daniel-santos-7/dpga-ieee-sscs-contest/README.md

# DIGITALLY PROGRAMMABLE GAIN AMPLIFIER

## 1. LIST OF THE INVOLVED TEAM MEMBERS

- Francisco de Assis Brito Filho (Faculty member)
- Hugo Dias Giló (Undergraduate student)
- Daniel Da Silva Santos (Undergraduate student)

## 2. A SHORT DESCRIPTION OF THE CIRCUIT

<p align="justify">The proposed circuit is a Digitally Programmable Gain Amplifier (DVGA) which will work to amplify voltage signal with programmable gain options, ranging from 1 V / V to 256 V / V. The main core is an OTA Miller with output buffer configured as an inverter amplifier. The circuit feedback resistances is controlled by 8 CMOS switches (Transmission Gates) that are configured according to binary word stored in the shift register which is connected to a Serial Peripheral Interface (SPI) that provides a connection for external control.</p>

## 3. PERFORMANCE SUMMARY TABLE

| Parameter |  Specification | Unit |
| --- | --- | --- |
| Vdd | 1.8 | V |
| Output Swing | (1.8 -0.64) | V |
| Open-loop Gain | 42.3 | dB |
| Programmable gain range | 4.6-250 | V/V |
| GBW | 2.8 | MHz |
| Phase margin | 47 | ° |
| Slew Rate | 0.7 | V/us |
| CMRR | 88 | dB |
| Area | 0.03 | mm² |

**Table 1** – DPGA performance.

## 4. A BLOCK DIAGRAM

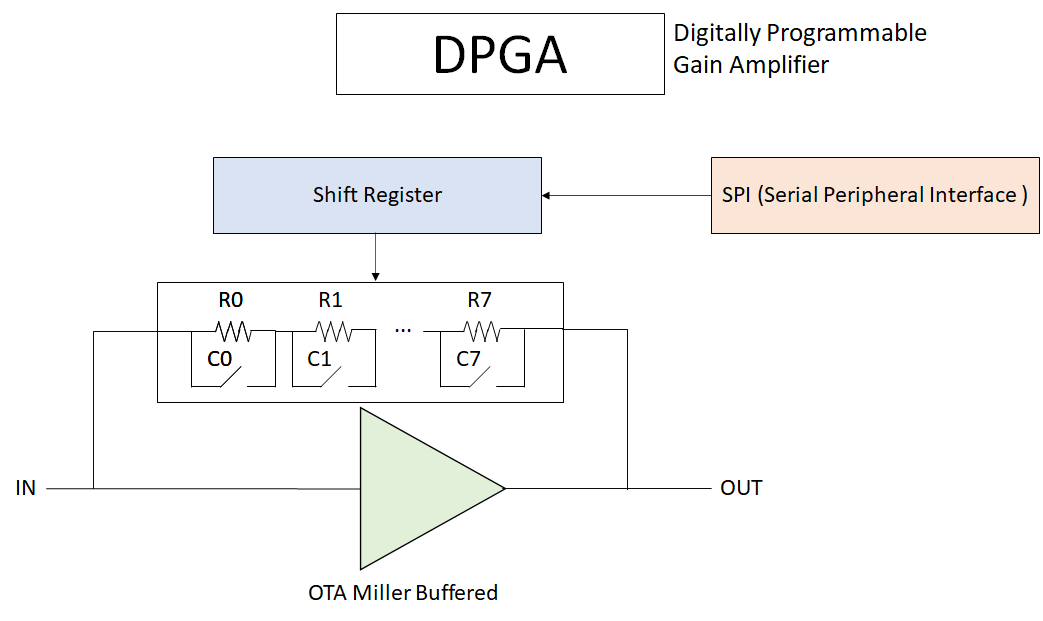
[picture p1: .github/dpga-block-diagram.png]


**Figure 1** – DPGA Block Diagram.

<p>The circuit is composed by an operational amplifier with adjusted gain programmable using CMOS switches. The programmable interface is a serial input as an SPI in order to provide access to external devices to control the gain.</p>

## 5. SCHEMATICS OF THE CRITICAL CIRCUIT CORE

Below are the schematics of the critical circuit core, an Operational Amplifier using the OTA Miller with output buffer.

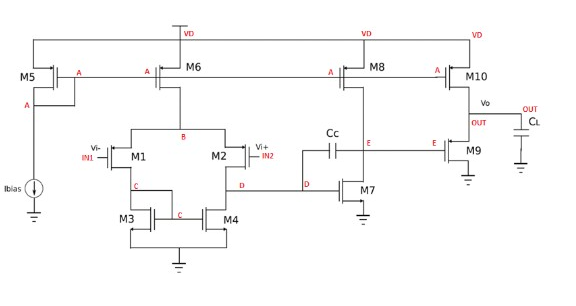
[picture p2: .github/ota-miller-with-output-buffer.png]


**Figure 2** - OpAmp with digitally programmable schematic.

<p align="justify">The negative feedback loop of the Operational Amplifier has resistances controlled by CMOS switches in order to program the overall gain, as in figure 3.</p>

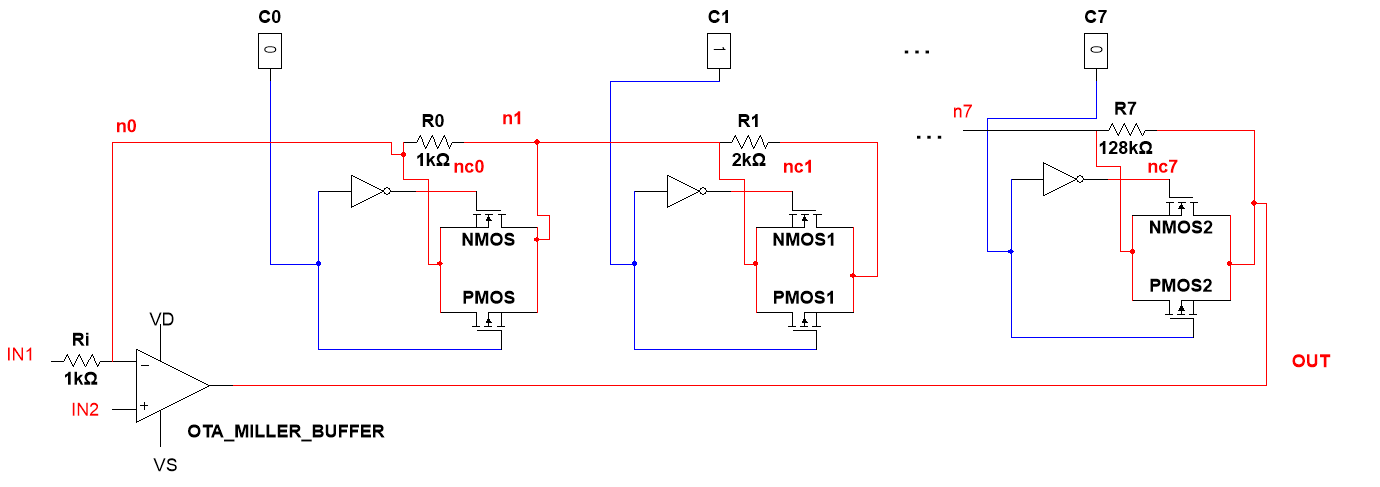
[picture p3: .github/opamp-with-digitally-programmable-schematic.png]


**Figure 3** - OpAmp with digitally programmable schematic.

## 6. CREATED SCHEMATICS
Below are the schematics created in the XSCHEM software.

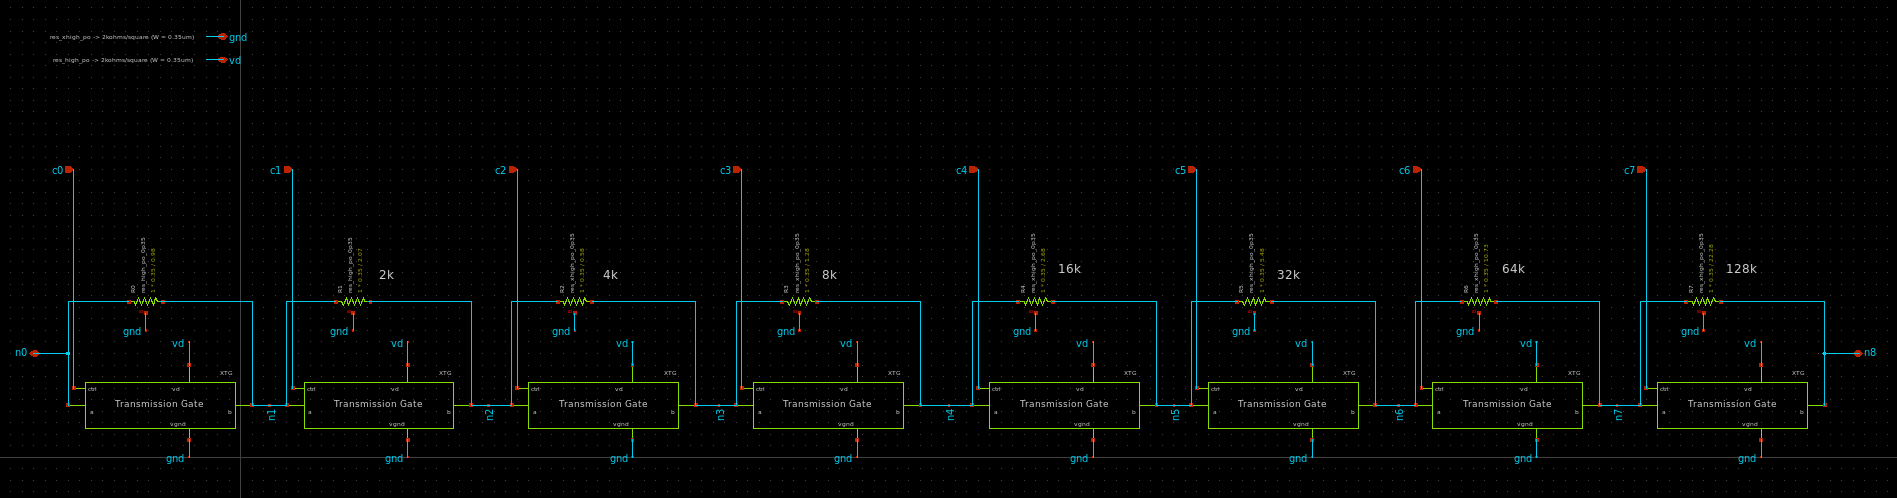
[picture p4: .github/schematic/digpot.png]


**Figure 4** - Digital potentiometer.

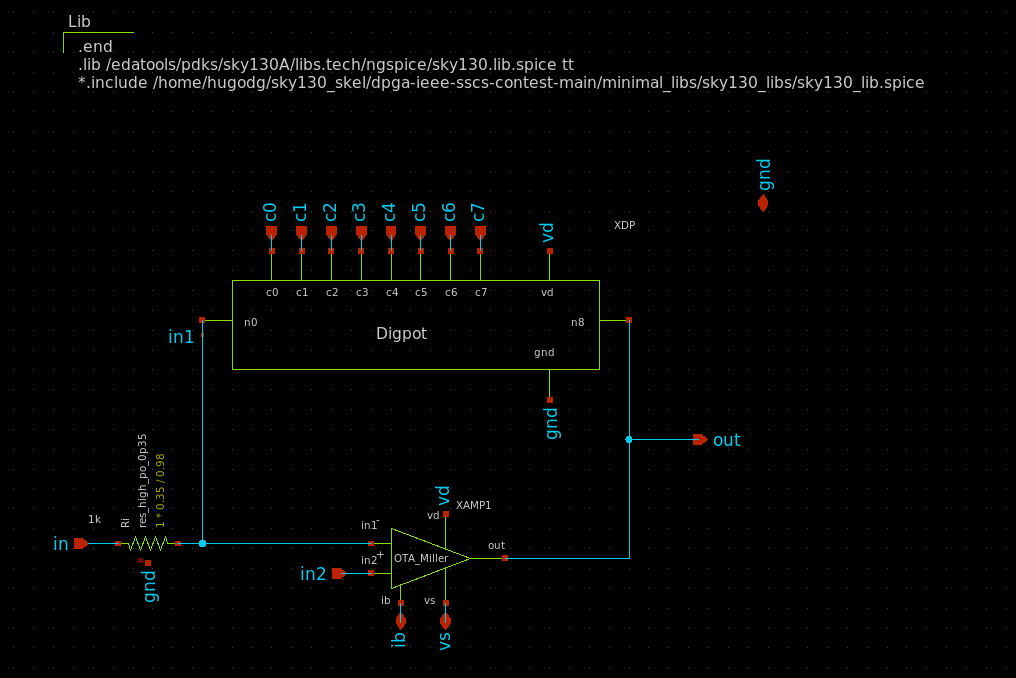
[picture p5: .github/schematic/dpga.png]


**Figure 5** - Digital potentiometer and OTA.

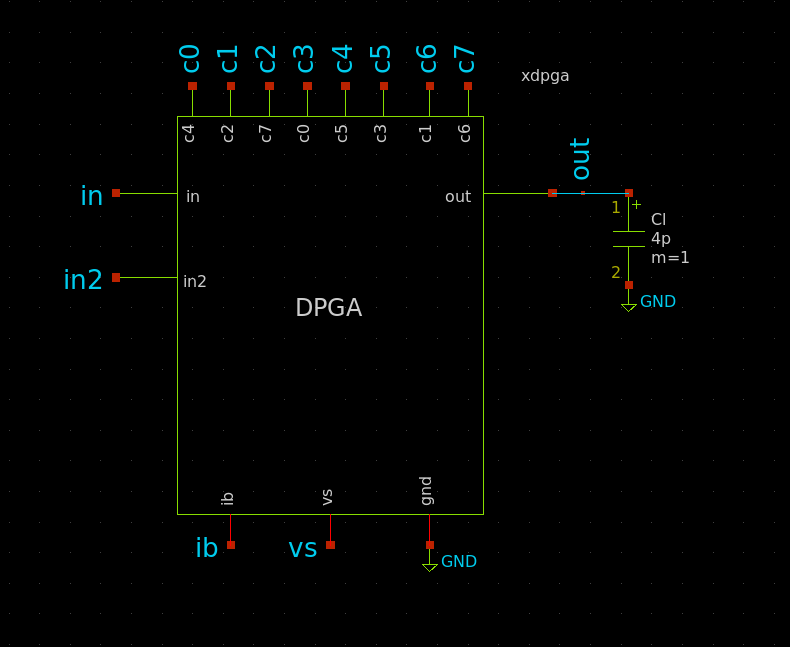
[picture p6: .github/schematic/dpga_with_cload.png]


**Figure 6** - DPGA top entity with load.

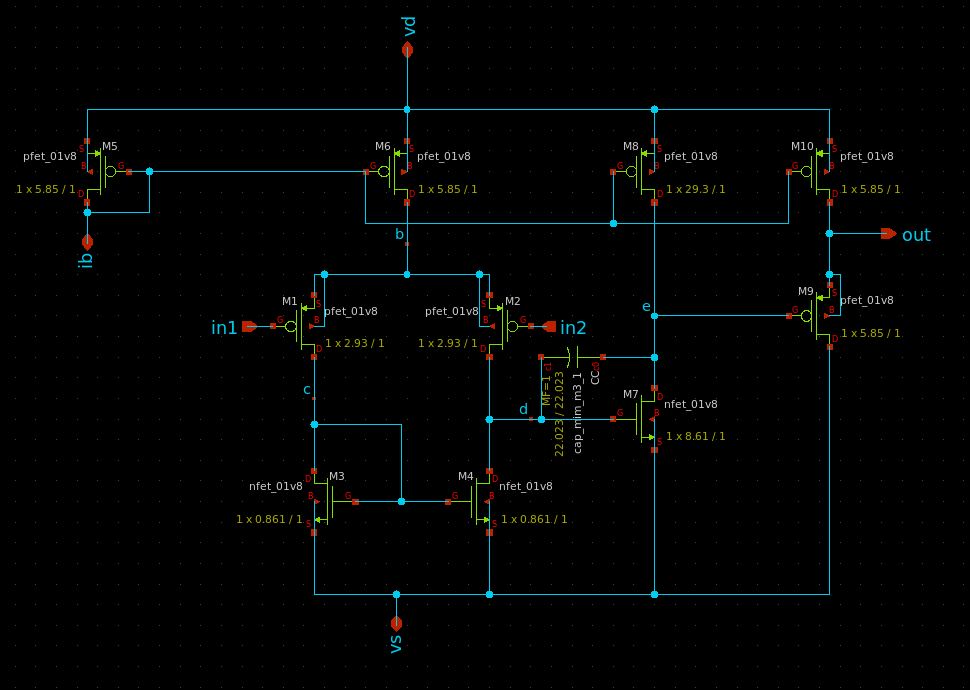
[picture p7: .github/schematic/ota.png]


**Figure 7** - OTA Miller schematic.

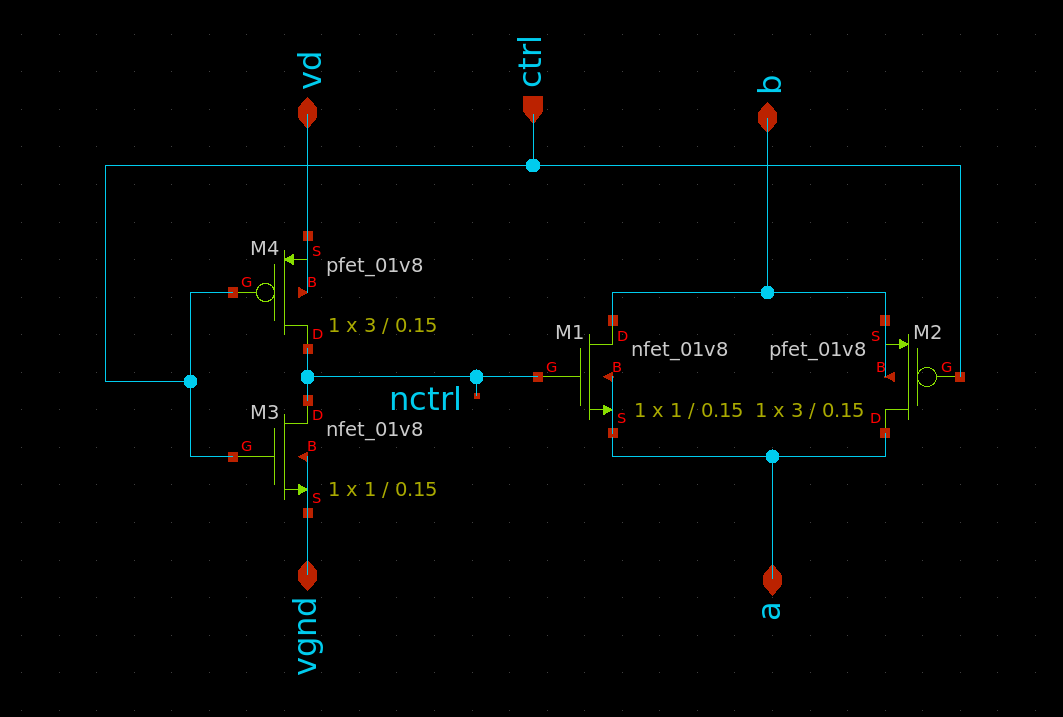
[picture p8: .github/schematic/tg.png]


**Figure 8** - Transmission gate with control.

## 7. Layouts

The analog and digital circuit layouts created will be presented below. 

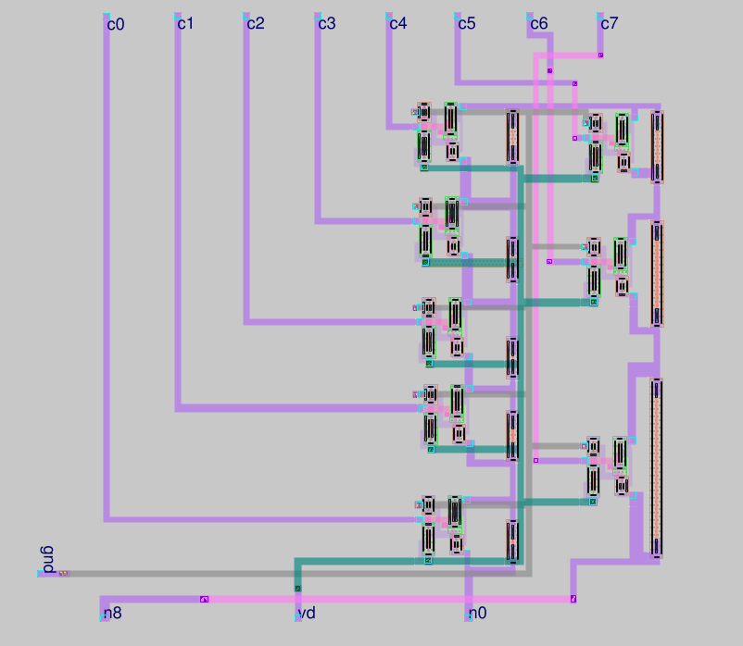
[picture p9: .github/layout/digpot.png]


**Figure 9** - Digital potentiometer layout.

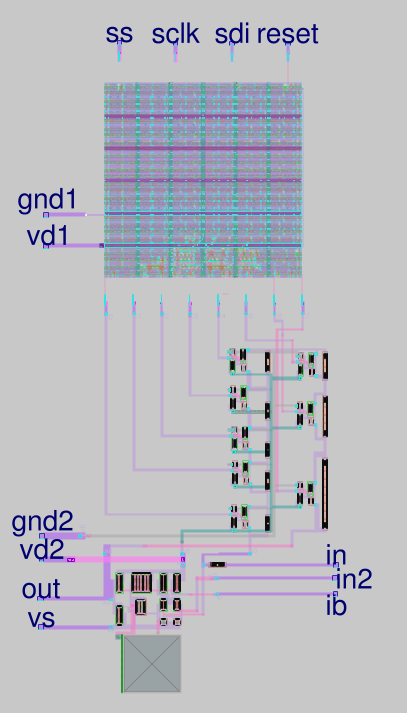
[picture p10: .github/layout/dpga_spi.png]


**Figure 10** - DPGA layout.

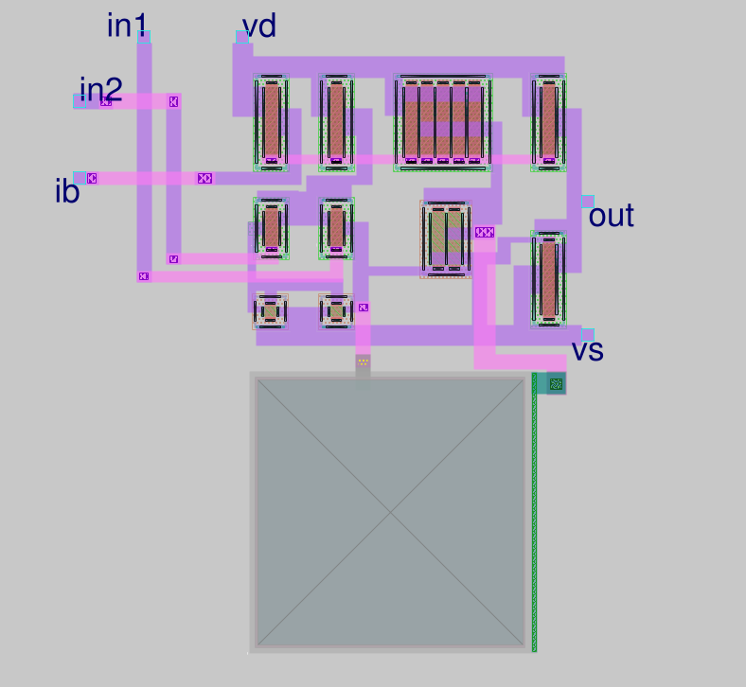
[picture p11: .github/layout/ota.png]


**Figure 11** - OTA Miller layout.

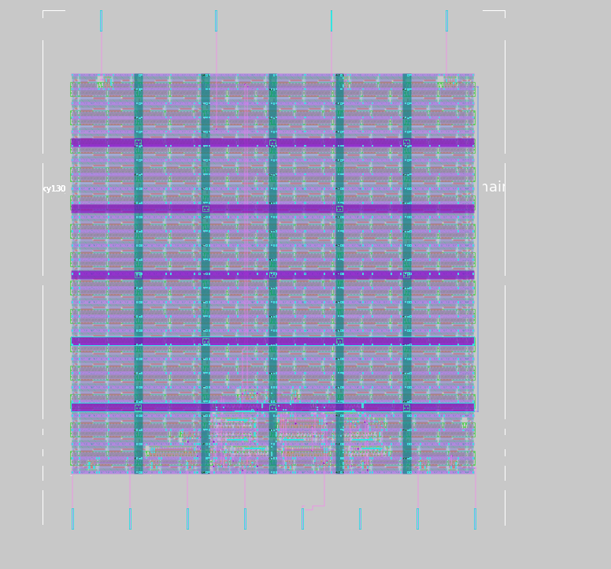
[picture p12: .github/layout/spi.png]


**Figure 12** - SPI module layout.

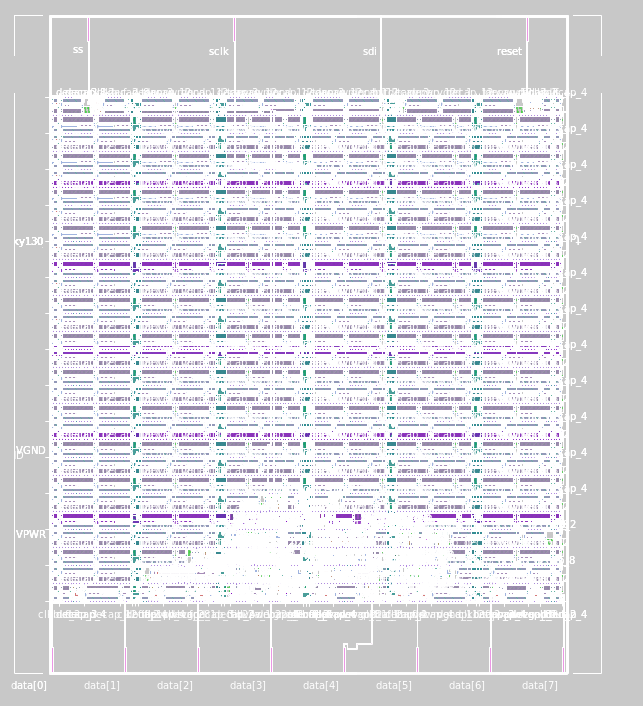
[picture p13: .github/layout/spi_ports.png]


**Figure 13** - SPI module layout with ports highlights.

## 8. Simulations
The results of the simulations carried out will be presented below.

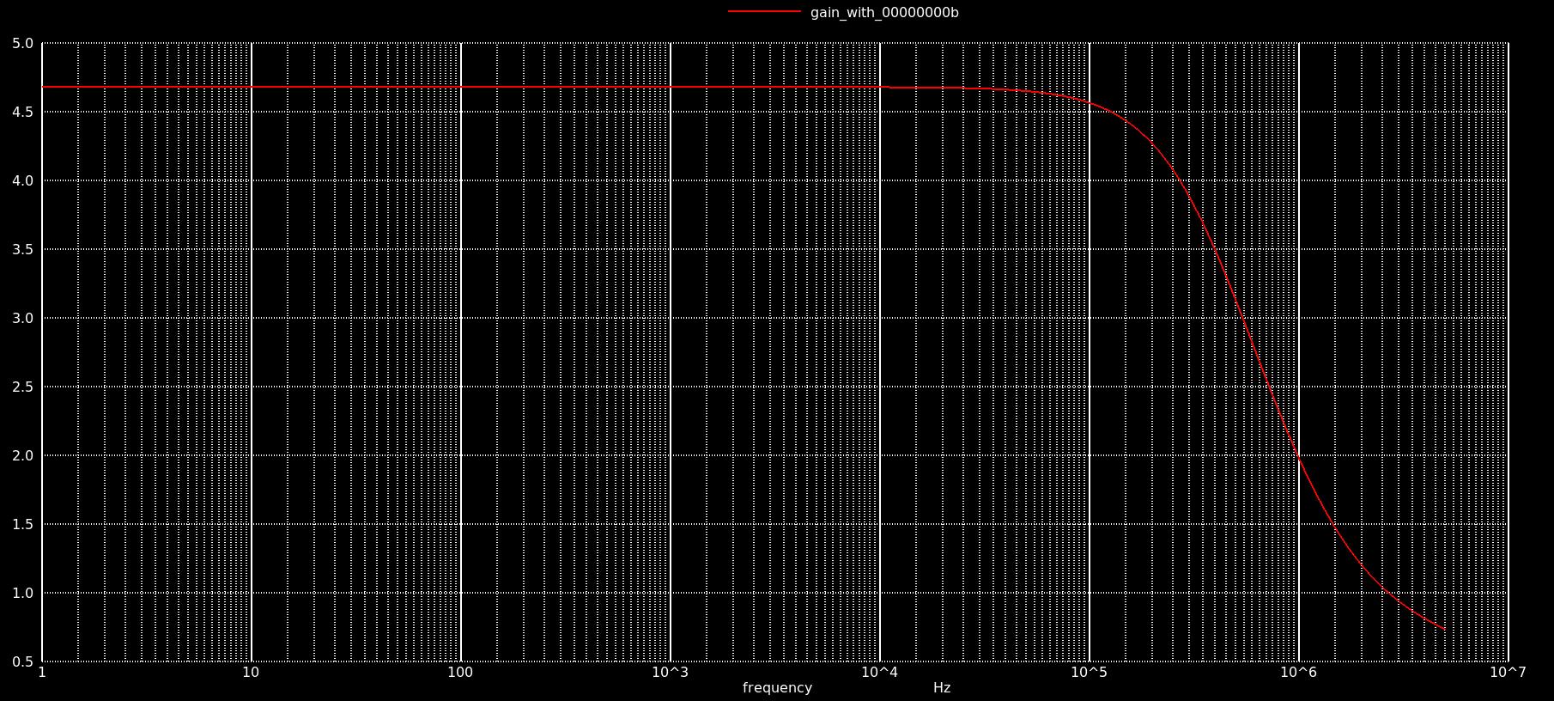
[picture p14: .github/simulations/digpot_tb-00000000b.png]


**Figure 14** - DPGA minimum gain.

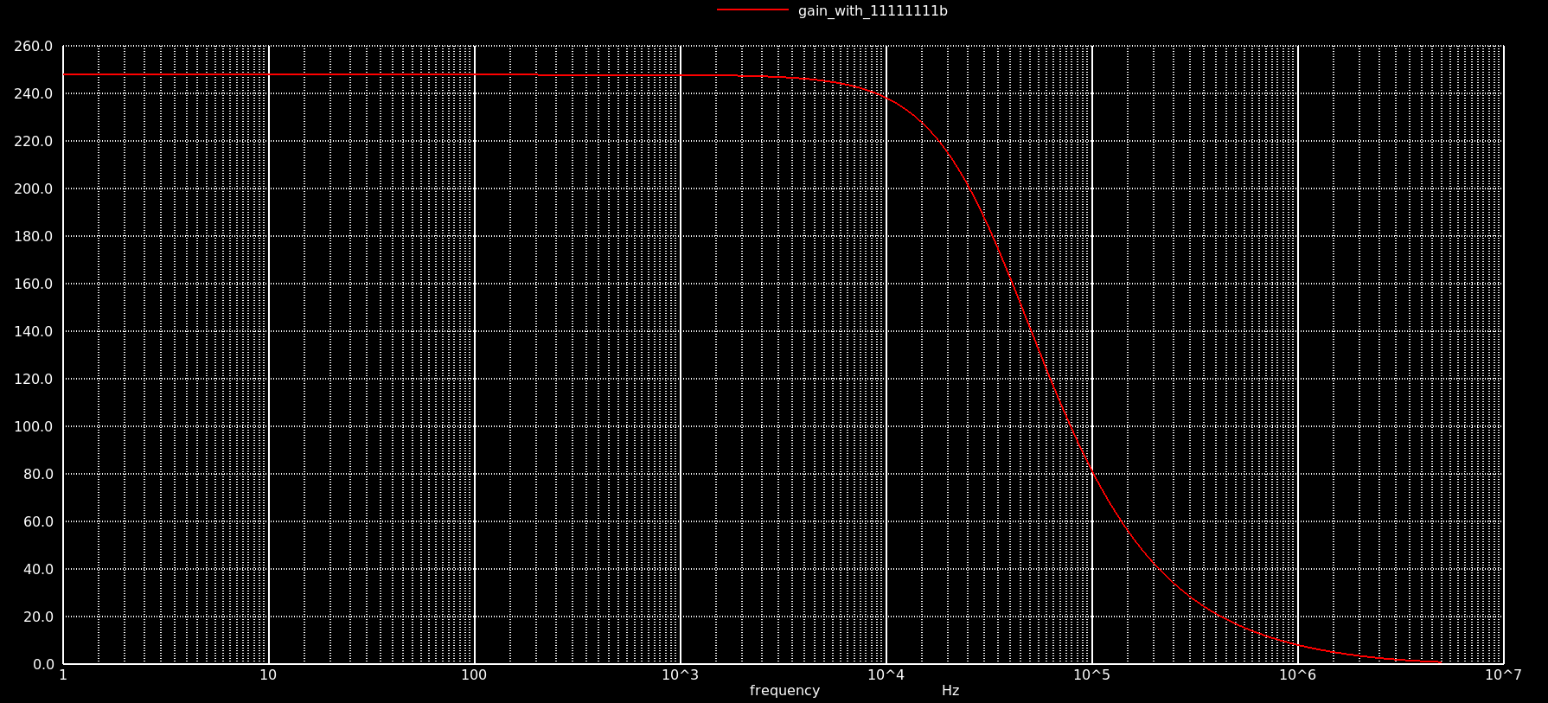
[picture p15: .github/simulations/dpga_tb-11111111b.png]


**Figure 15** - DPGA maximum gain.

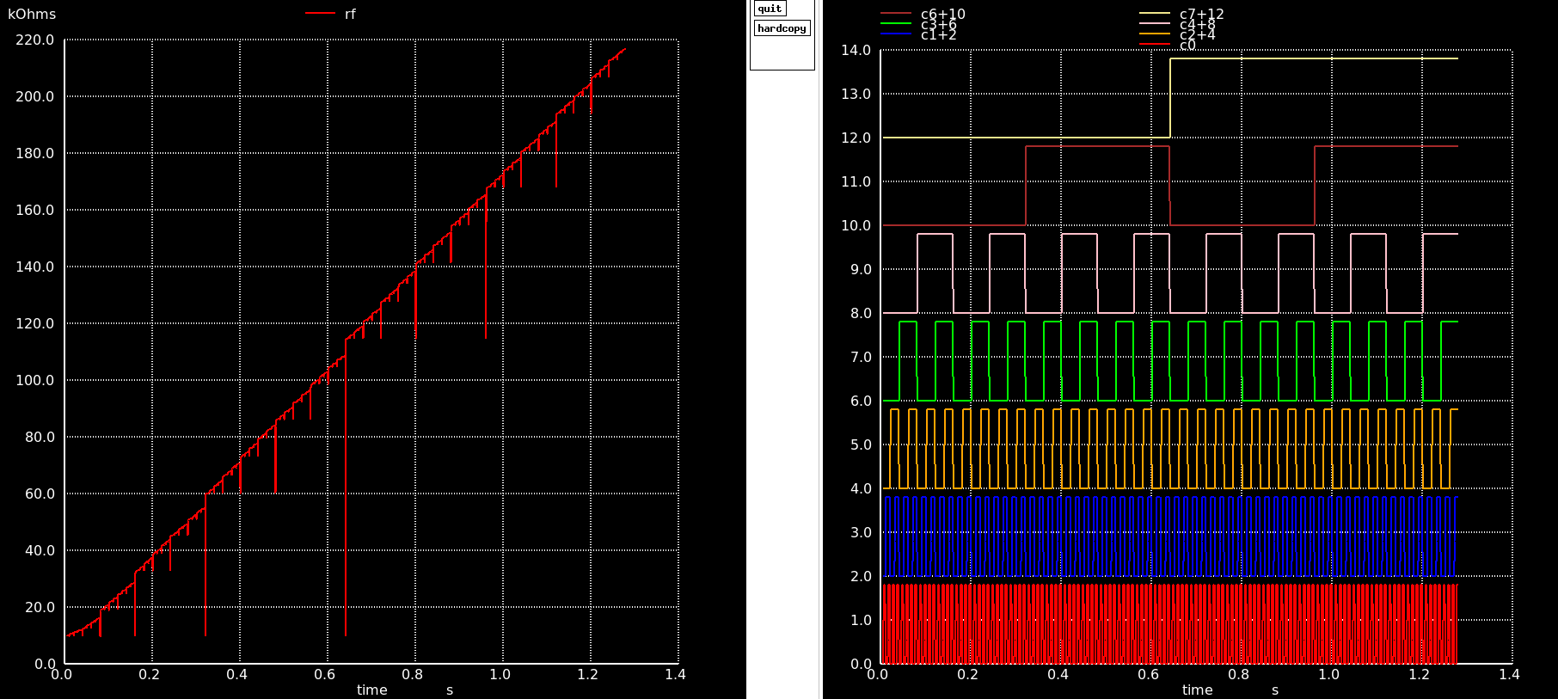
[picture p16: .github/simulations/digpot_tb.png]


**Figure 16** - Digital potentiometer simulation.

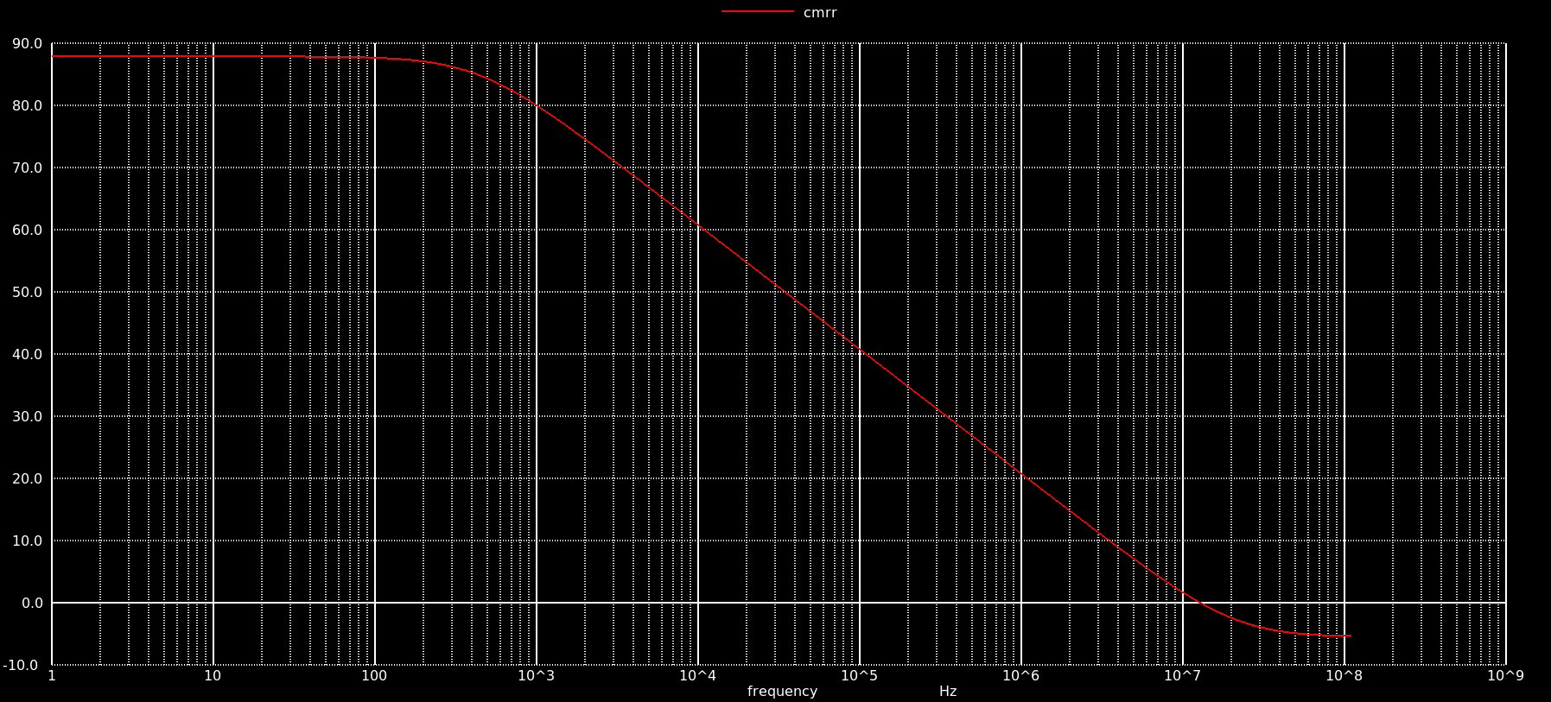
[picture p17: .github/simulations/ota_CMRR.png]


**Figure 17** - OTA CMRR simultation.

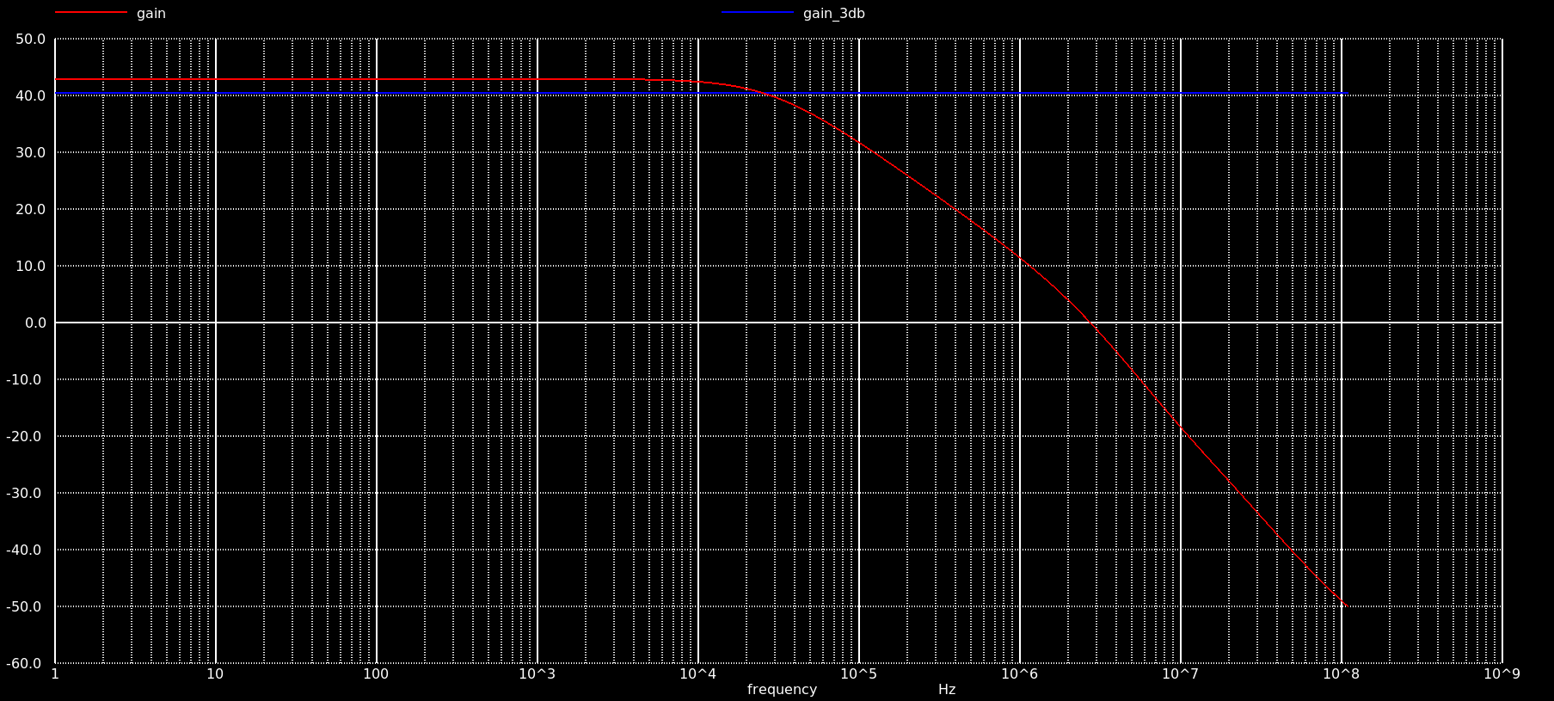
[picture p18: .github/simulations/ota_ac-gain.png]


**Figure 18** - OTA gain.

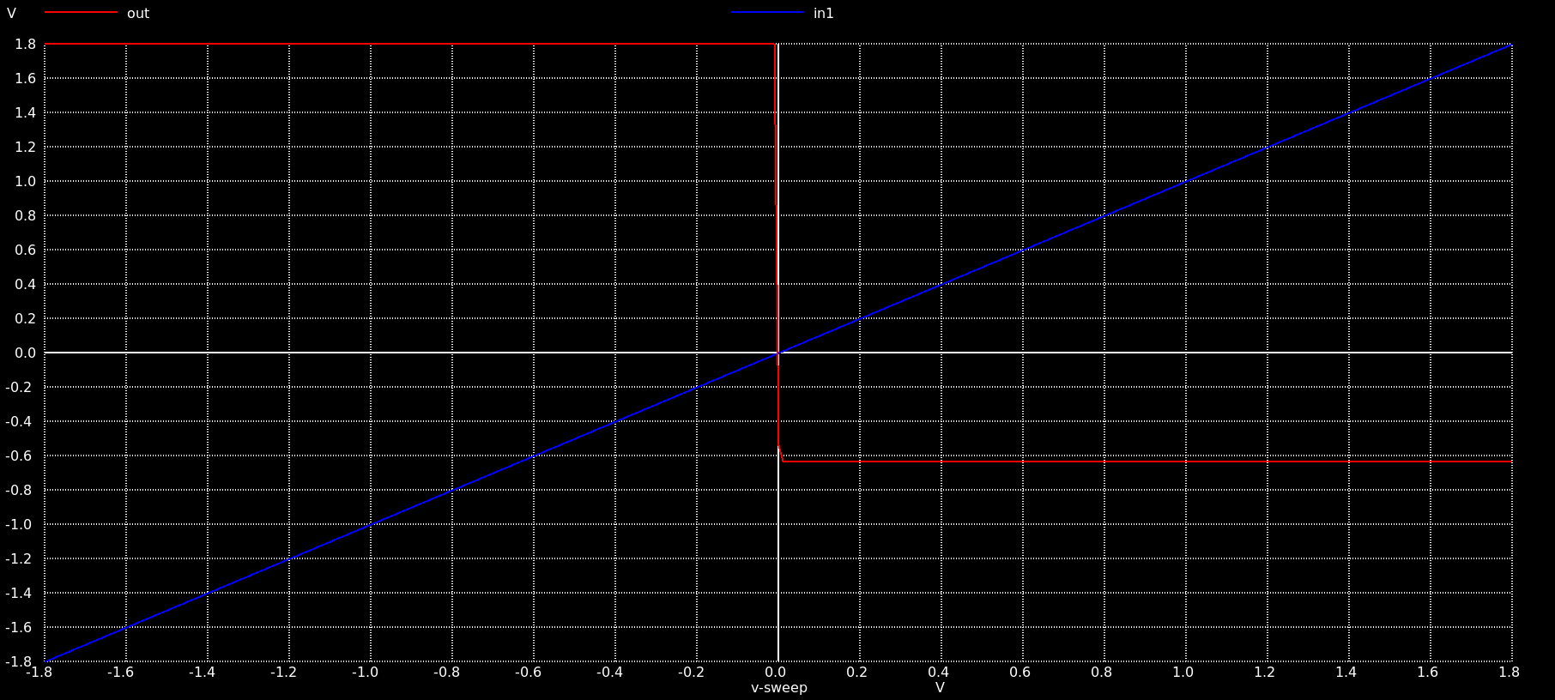
[picture p19: .github/simulations/ota_dc.png]


**Figure 19** - OTA DC simulation.

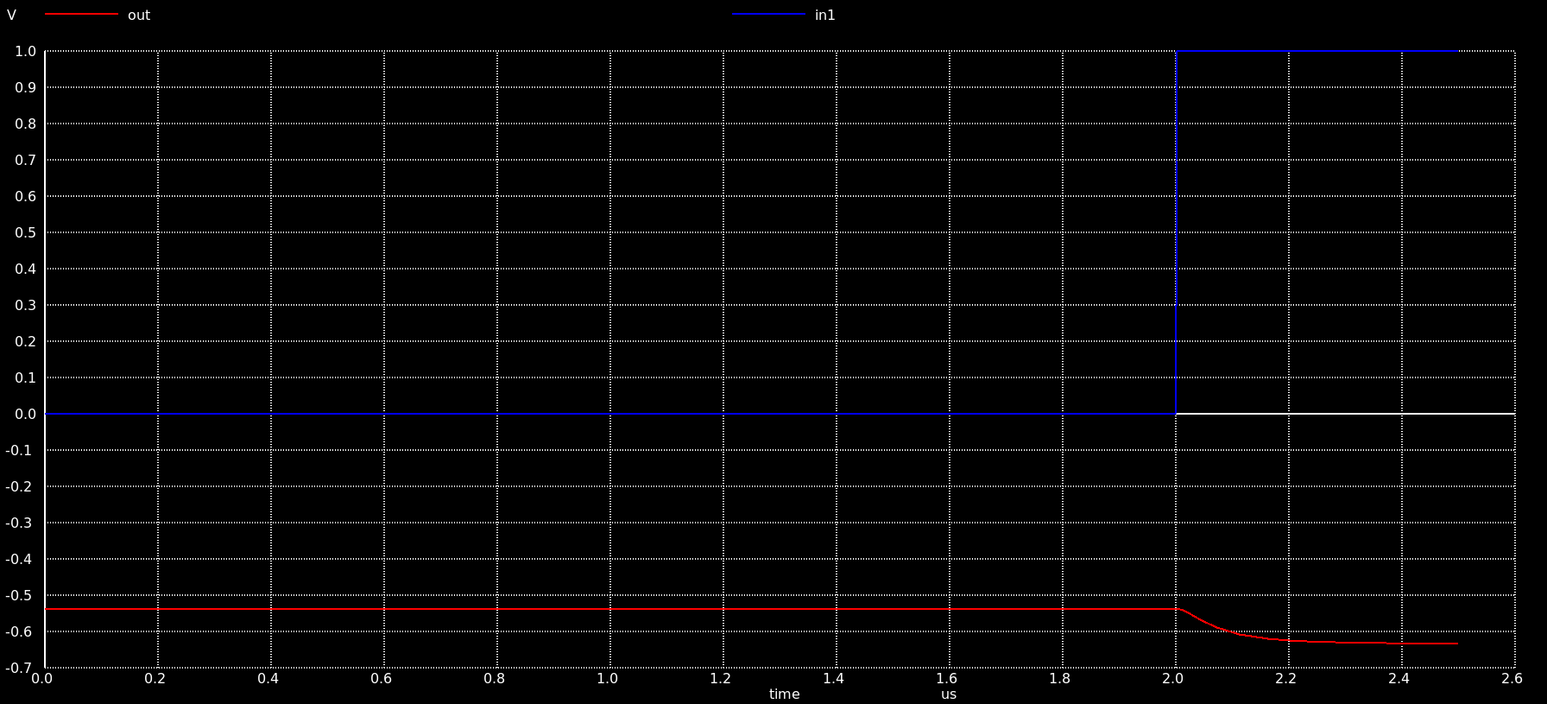
[picture p20: .github/simulations/ota_large-signal.png]


**Figure 20** - OTA large signal simulation.

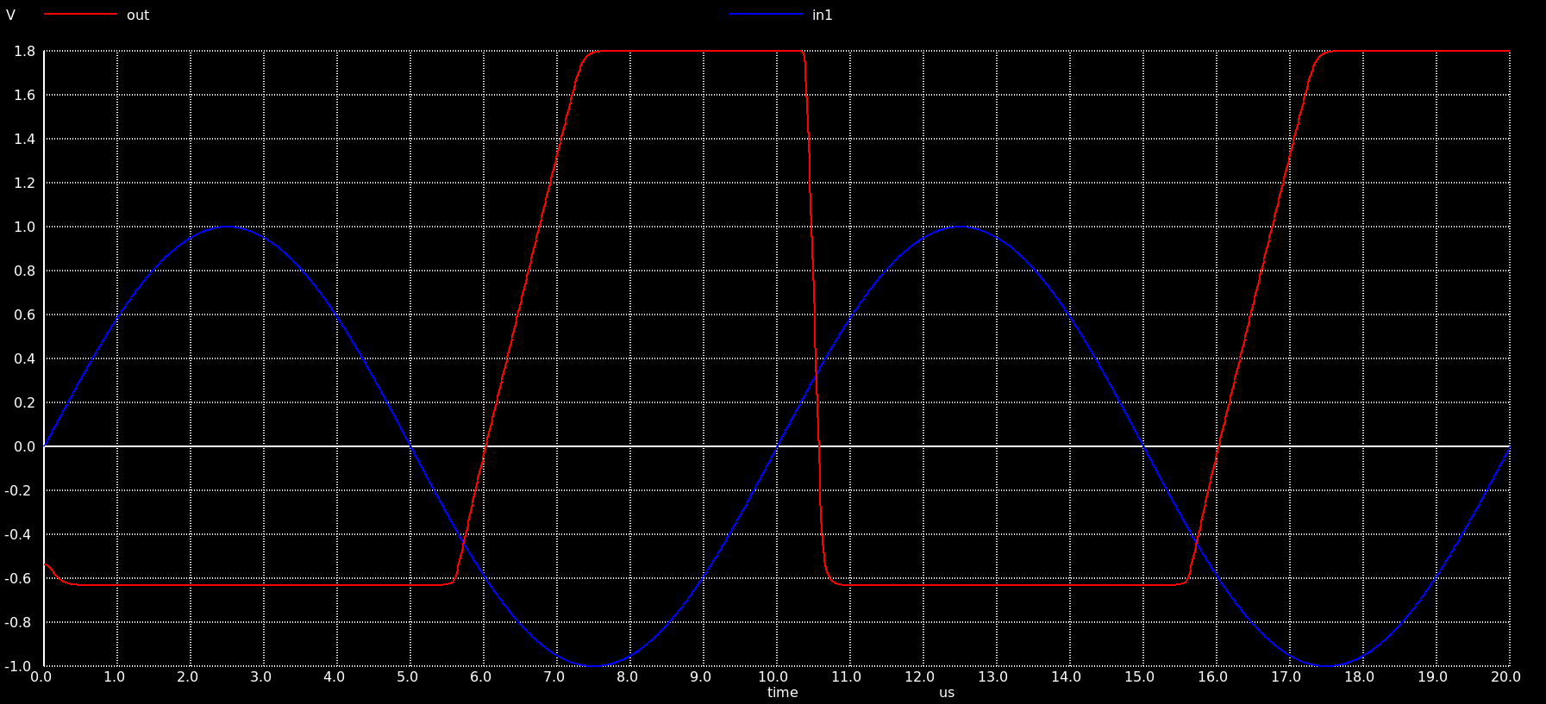
[picture p21: .github/simulations/ota_tran.png]


**Figure 21** - OTA transient simulation.

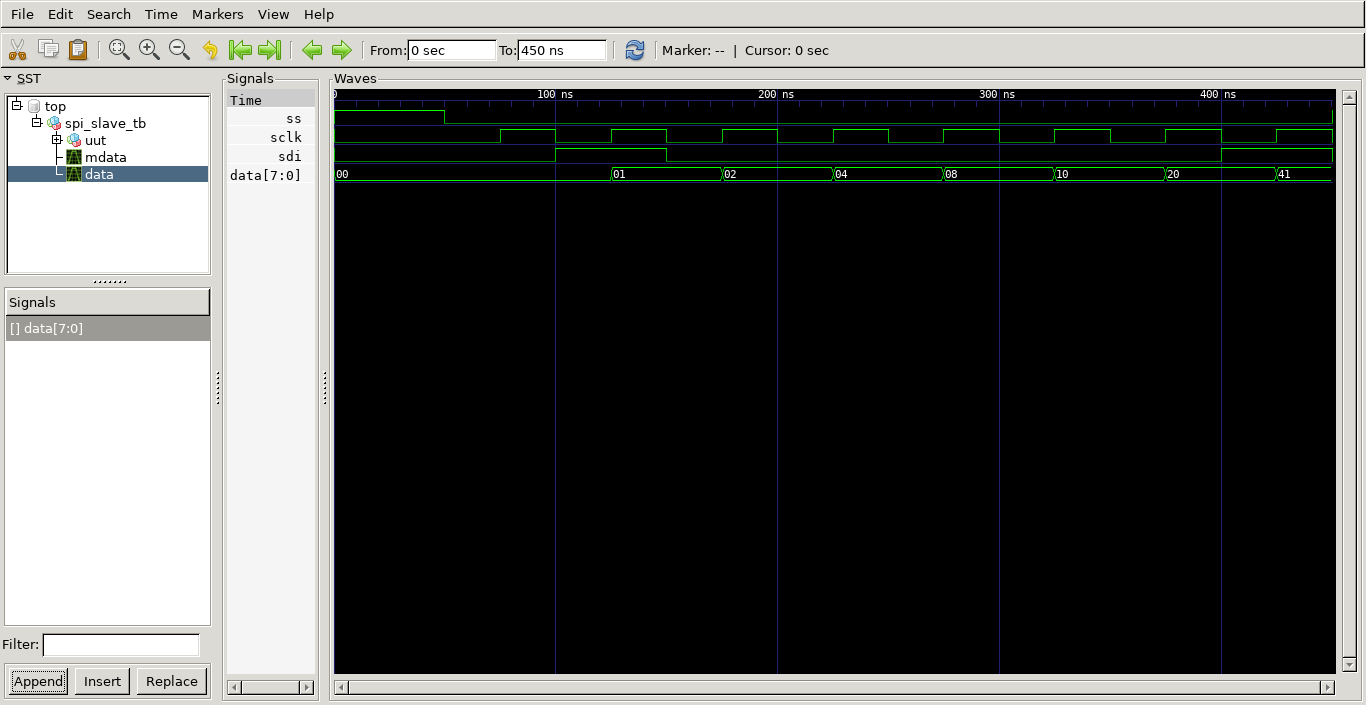
[picture p22: .github/simulations/spi_slave.png]


**Figure 22** - SPI simulation.

## 8. PORTS

| Port | type |
| --- | --- |
| ss | digital input |
| sclk | digital input |
| sdi | digital input |
| reset' | digital input |
| in | analog input |
| in2 | analog input |
| Ib | analog input |
| out | analog output |
| vd1 | power |
| gnd1 | power |
| vd2 | power |
| vs | power |
| gnd2 | power |

## 9. APPLICABLE REFERENCES

Main references for OpAmp Design are:

- P. E. Allen, D. R. Holberg. CMOS Analog Circuit Design. 2nd Ed., Oxford, New York, 2002.
- B. Razavi. Design of Analog CMOS Integrated Circuits. McGraw -Hill, New York, 2001.
- P. Jespers, B. Murmann. Systematic Design of Analog CMOS Circuits: Using Pre-Computed Lookup. Cambridge Press. 2017.
