daniel-santos-7/dpga-ieee-sscs-contest/.github/simulations/ota_ac-phase.png

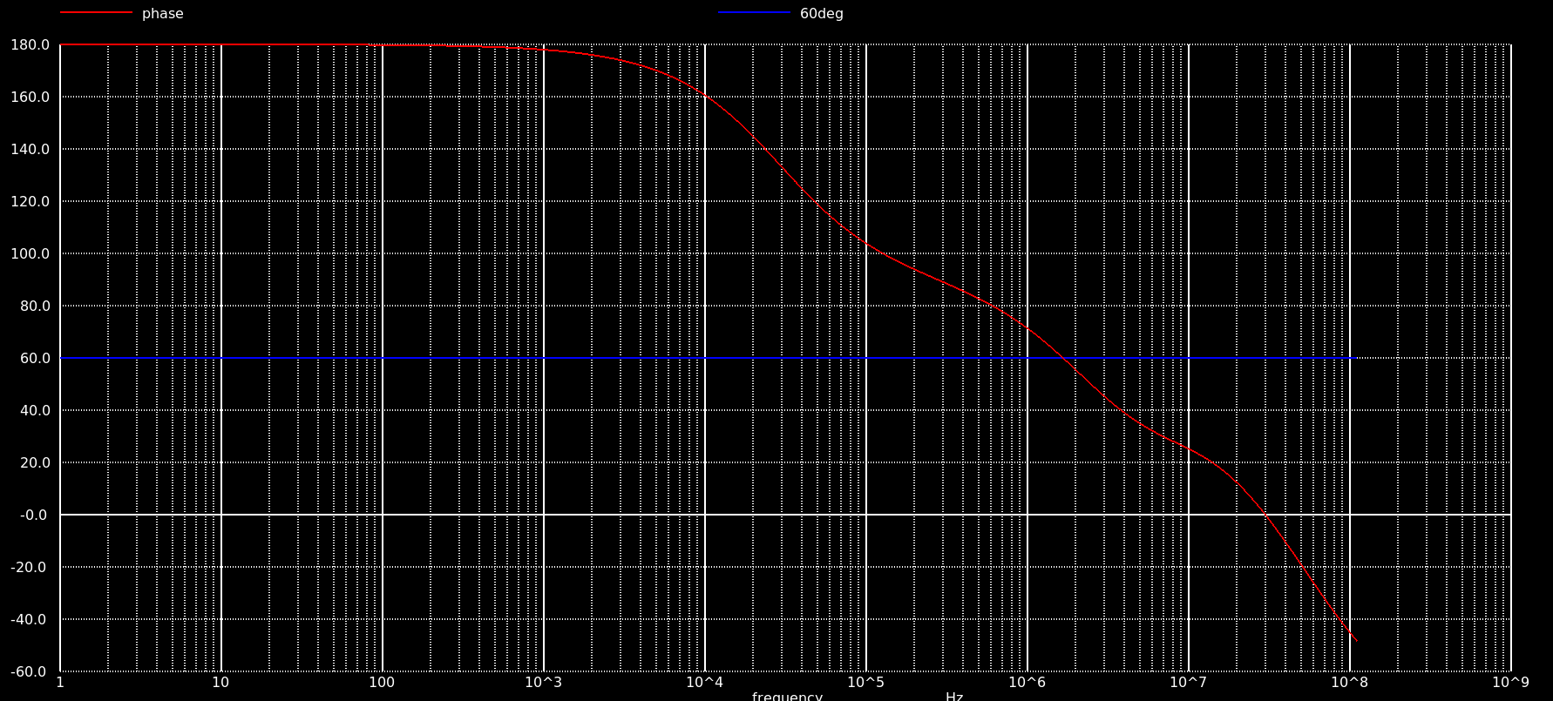
.github/simulations/ota_ac-phase.png
