daniel-santos-7/dpga-ieee-sscs-contest/.github/simulations/tg_tb.png

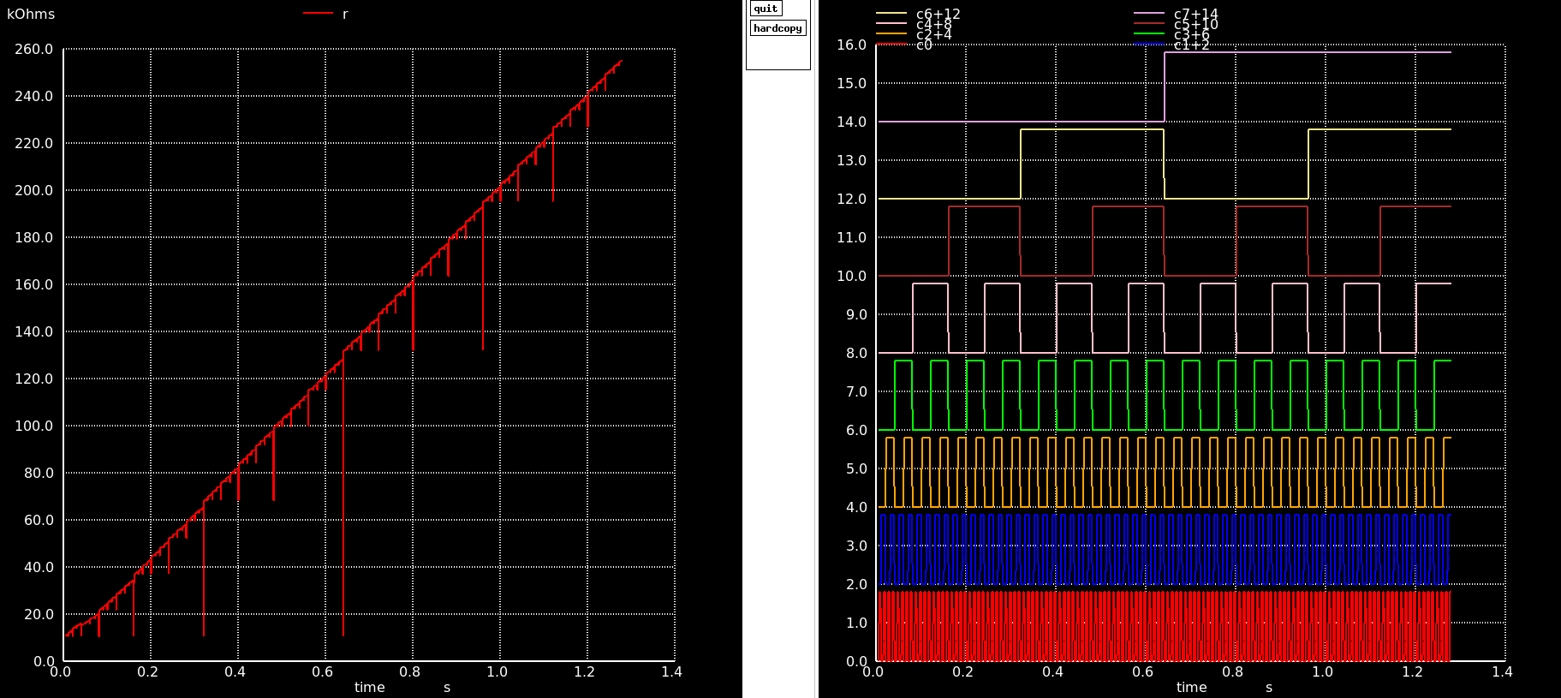
.github/simulations/tg_tb.png
