daniel-santos-7/dpga-ieee-sscs-contest/spice/ota_tb-ac.spice

*TB AC OTA BUFFERED
.include ../minimal_libs/sky130_libs/sky130_lib.spice
.include ./ota.spice
*.lib "/home/hugodg/sky130_skel/dpga-ieee-sscs-contest-main/minimal_libs/skywater-pdk-libs-sky130_fd_pr/models/sky130.lib.spice" tt


X1	IN1	IN2	VD	VS	A	OUT	 ota


CL	OUT	0	4p
*CC	D	E	0.5p
*CC	D	E	0.88p

Ibias A 0 5.53u

VDD VD 0 1.8
VSS VS 0 -1.8

VIN1 IN1 0 DC 0 AC 1
VIN2 IN2 0 DC 0

*Malha Fechada
*VIN1 X 0 DC 0 AC 1
*Ri X IN1 10k
*RF IN1 OUT 30k

* cmd 	step	stop
.ac	dec	2000	1	110Meg

.end

.control

destroy all
run

*Magnitude
let gain=db(abs(OUT/IN1))
let gain_3db=40.4615
plot  gain gain_3db

*Fase em graus
let phase = (ph(OUT)-ph(IN1))*180/3.14159
plot  phase 60deg

.endc
