daniel-santos-7/dpga-ieee-sscs-contest/(commit log)

2021-09-19 spi interface created
2021-10-01 openlane config
    [pin_order.cfg]
2021-10-01 xschem files
    [ota.sch, ota_tb-dc.sch]
2021-10-02 openlane automation
    [pin_order.cfg]
2021-10-20 magic digpot, ota, spi
2021-10-20 xschem updates
    [digpot-tb.sch, digpot.sch, dpga-tb.sch, dpga.sch, ota_tb-ac.sch, ota_tb-common-mode.sch, ota_tb-diff-mode.sch, ota_tb-largesignal.sch]
2021-10-21 pin_order.cfg changed
    [pin_order.cfg]
2021-10-22 spi slave figure added
2021-10-22 spi slave figure changes
2021-10-22 some files removed
    [ota_tb-common-mode.sch, ota_tb-diff-mode.sch]
